dragino/TrackerD/Example/BLE_Indoor_Positioning_Software/BLE_Positioning/office_map.png

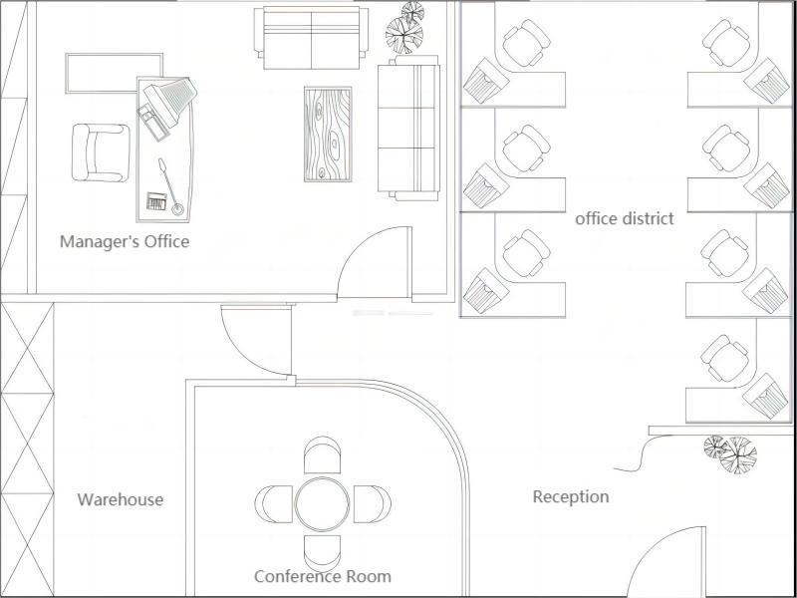
Example/BLE_Indoor_Positioning_Software/BLE_Positioning/office_map.png
