dragino/TrackerD/(threads)

Thread 11 (2022-12-11):

Enable/Disable LED (LON) is always set to ON state

Martin-100, 2022-12-11:
Common.cpp -> void SYS::config_Read(void) ->contains on line 618-622:

//lon
  lon = DATA.readUChar(addr1);           
  addr1 += sizeof(unsigned char);
  if(lon == 0)
    lon = 1;

So writing a 0 to disable the leds results in turning them back on again?

mkwillis, 2023-03-09:
Can this issue be fixed by editing the code?.... Its a highly annoying LED

namejinnameyuan, 2023-04-23:
Yes, you can compile the code to change it. I changed it in v1.4.4. Before, 1 was on and 2 was off.

P-etr, 2023-04-23:
Hi, my tracker has FW 1.4.4. and AT+LON keeps returning to 1.
So I can't turn off the LED. Is it possible to somehow turn off the LED now? Will this be fixed in future versions?

mkwillis, 2023-04-23:
Yes LED settings DO NOT stick... We need a fix pls

namejinnameyuan, 2023-04-24:
Hi
I will release a new version in the next few days, fix problems, and add features will be described

------------------&nbsp;原始邮件&nbsp;------------------
发件人:                                                                                                                        "dragino/TrackerD"                                                                                    ***@***.***&gt;;
发送时间:&nbsp;2023年4月23日(星期天) 晚上8:04
***@***.***&gt;;
***@***.******@***.***&gt;;
主题:&nbsp;Re: [dragino/TrackerD] Enable/Disable LED (LON) is always set to ON state (Issue #11)

Hi, my tracker has FW 1.4.4. and AT+LON keeps returning to 1.
 So I can't turn off the LED. Is it possible to somehow turn off the LED now? Will this be fixed in future versions?

—
Reply to this email directly, view it on GitHub, or unsubscribe.
You are receiving this because you commented.Message ID: ***@***.***&gt;

namejinnameyuan, 2023-04-24:
Hi
I will release a new version in the next few days, fix problems, and add features will be described

------------------&nbsp;原始邮件&nbsp;------------------
发件人:                                                                                                                        "dragino/TrackerD"                                                                                    ***@***.***&gt;;
发送时间:&nbsp;2023年4月23日(星期天) 晚上9:18
***@***.***&gt;;
***@***.******@***.***&gt;;
主题:&nbsp;Re: [dragino/TrackerD] Enable/Disable LED (LON) is always set to ON state (Issue #11)

Yes LED settings DO NOT stick... We need a fix pls

—
Reply to this email directly, view it on GitHub, or unsubscribe.
You are receiving this because you commented.Message ID: ***@***.***&gt;

Thread 12 (2023-01-22):

AT+FTIME value is multiplied by 1000 in the actual config

bienvuinfo, 2023-01-22:
TrackerD v1.4.4

Entering the command AT+FTIME=150
then checking the actual config with AT+CFG returns
AT+FTIME=150000

namejinnameyuan, 2023-04-23:
Set the time in seconds, and the milliseconds he uses in ESP32 will be converted

bienvuinfo, 2023-04-24:
I want to use AT+CFG to backup the actual device configuration then simply 'replay' the output to restore the config.

AT+FTIME is the only parameter that cannot restored 'as-is' and requires transformation.

It would be very convenient to have the same values.

namejinnameyuan, 2023-04-24:
ok, you want AT+FTIME also use MS as the unit?

------------------&nbsp;原始邮件&nbsp;------------------
发件人:                                                                                                                        "dragino/TrackerD"                                                                                    ***@***.***&gt;;
发送时间:&nbsp;2023年4月24日(星期一) 下午4:28
***@***.***&gt;;
***@***.******@***.***&gt;;
主题:&nbsp;Re: [dragino/TrackerD] AT+FTIME value is multiplied by 1000 in the actual config (Issue #12)

I want to use AT+CFG to backup the actual device configuration then simply 'replay' the output to restore the config.

AT+FTIME is the only parameter that cannot restored 'as-is' and requires transformation.

It would be very convenient to have the same values.

—
Reply to this email directly, view it on GitHub, or unsubscribe.
You are receiving this because you commented.Message ID: ***@***.***&gt;

bienvuinfo, 2023-05-01:
Yes, milliseconds.
Same unit in AT+CFG and AT+FTIME.
Thanks.

Thread 13 (2023-01-22):

Cannot modify the configuration with downlink messages

bienvuinfo, 2023-01-22:
TrackerD 1.4.4, TTN network V3

Clearing ALARM with the downlink payload 0x02 01 works well  as expected.

Unfortunately no other configuration parameter is actually changed with a downlink payload
f.ex:
```
0x01 00 01 2C // Same as AT+TDC=300000
0x03 00 01 2C // Same as AT+MTDC=3000000
0xAE 00 // Same as AT+LON=0
0xA5 01 00 00 // Same as AT+SMOD=1,0,0
```

The download messages are well received and decoded by the node.
```
BAT:4.00 V
1543393: UpLinkCounter = 1
EV_TXSTART
1555939: TXMODE, freq=868300000, len=18, SF=7, BW=125, CR=4/5, IH=0
Packet queued
start single rx: now-rxtime: 3
1871548: RXMODE_SINGLE, freq=868300000, SF=7, BW=125, CR=4/5, IH=0
Rssi=-63
1874664: EV_TXCOMPLETE (includes waiting for RX windows)
**Received:A5 02 00 02**
Received ack
Enter sleep mode
```

My Configuration
```
AT+MODEL=TrackerD ,v1.4.4
AT+ADR=1
AT+DR=5
AT+TXP=0
AT+SMOD=1,0,1
AT+TDC=120000
AT+MTDC=100000
AT+ATDC=30000
AT+FTIME=90000
AT+INTWK=1
AT+LON=1
AT+CHE=1
AT+NMEA353=0
AT+NMEA886=0
AT+CFM=1
AT+PNACKMD=1
AT+PDOP=7.00
AT+DWELLT=0
AT+SHOWID=0
AT+BLEMASK==0
AT+WiFiMASK==0
AT+PT=14
```

namejinnameyuan, 2023-04-23:
I checked what is the problem and I will fix it in the latest version V.1.4.5

alternator7, 2024-07-29:
@namejinnameyuan Was this resolved?  We are experiencing the same problem with downlink payloads not changing parameters on the device.  We don't any commits based on this issue...

namejinnameyuan, 2024-07-30:
Downlink modification SMOD, fixed

Thread 15 (2023-02-17):

Realtime GNSS Positioning with Altitude and hdop

kbox-one, 2023-02-17:
Would be great to have a more detailed GNSS positioning information with altidude and hdop. Maybe you could add one using Uplink on FPORT=9 ?

ffries, 2023-04-10:
+1
I really need this feature.

namejinnameyuan, 2023-04-23:
Need to add height and HDOP? Playload will be exceeded on some frequency bands, and some SFs are not applicable.
Does the alarm only need to be reported once and then automatically exit?

kbox-one, 2023-04-24:
I have no special demands for the alarm function. But I would be very happy if there is an additonal FPORT number (for example 9) that contains at least the following payload:
Latitude + Longitude + Altitude + HDOP(or PDOP)
Size (bytes) would be only = 4 + 4 + 2 + 1
That would not exceed the maximum size as it is smaller than the FPORT=2 payload :-)

namejinnameyuan, 2023-04-25:
I am busy with other things, I will add it when I am free
------------------&nbsp;原始邮件&nbsp;------------------
发件人:                                                                                                                        "dragino/TrackerD"                                                                                    ***@***.***&gt;;
发送时间:&nbsp;2023年4月25日(星期二) 凌晨0:07
***@***.***&gt;;
***@***.******@***.***&gt;;
主题:&nbsp;Re: [dragino/TrackerD] Realtime GNSS Positioning with Altitude and hdop (Issue #15)

I have no special demands for the alarm function. But I would be very happy if there is an additonal FPORT number (for example 9) that contains at least the following payload:
 Latitude + Longitude + Altitude + HDOP(or PDOP)
 Size (bytes) would be only = 4 + 4 + 2 + 1
 That would not exceed the maximum size as it is smaller than the FPORT=2 payload :-)

—
Reply to this email directly, view it on GitHub, or unsubscribe.
You are receiving this because you commented.Message ID: ***@***.***&gt;

Thread 16 (2023-04-10):

Trackerd does not go in sleep mode when in transport mode with no GPS available

ffries, 2023-04-10:
Dear all,

First let me explain what I need trackerd for : I want to do real-time mapping when I drive my car. (only a few days in a year when mapping my own networks to respect fair-use policies).  I would like to start mapping automatically when driving and I would like trackerd to go on sleep automatically when not moving.

Trackerd is connected to USB port in my car and is sitting right in front of the car glass with good visibility on the sky. The problem is that when GPS is lost inside the garage, trackerd does not go on sleep and led is flashing all the time looking for a GPS. Then battery goes off and I need to restart the car to power trackerd.

Trackerd is by now sitting on the floor with no movement and no vibration. It is sill blinking constanly until it goes off, so it could be looking for GPS before sleeping. If I connect to USB, as motion detection is on, it goes instantly on looking for GPS so I don't know precisely what is going on.

Is this a bug or a feature, please help. Here is my configuration:

```
AT+MODEL=TrackerD ,v1.4.4                        
AT+ADR=0                                                                
AT+DR=5                                                                 
AT+TXP=0                                                                
AT+SMOD=1,0,0                                                           
AT+TDC=1800000                                                          
AT+MTDC=300000                                                          
AT+ATDC=60000                                                           
AT+FTIME=150000                                                         
AT+INTWK=1                                                              
AT+LON=1                                                                
AT+CHE=0                                                                
AT+NMEA353=0                                                            
AT+NMEA886=1                                                            
AT+CFM=0                                                                
AT+PNACKMD=0                                                            
AT+PDOP=7.00                                                            
AT+DWELLT=0                                                             
AT+SHOWID=0                                                             
AT+BLEMASK=                                                             
AT+WiFiMASK=                                                            
AT+PT=14
```

ffries, 2023-04-10:
Sorry for the confusion, trackerd was in alarm mode.
It was pressed by my cat by error!

ffries, 2023-04-10:
Closing issue.

ffries, 2023-04-10:
Reopening, trackerd is still blinking.

ffries, 2023-04-11:
I found that AT+FTIME=150000000
I don't remember setting such a high value.

ffries, 2023-04-11:
My fault, I did set AT+FTIME=180000 by error copying the result from configuration

namejinnameyuan, 2023-04-23:
The setting unit of AT+FTIME command is S, three minutes AT+FTIME=180s.
The positioning is not successful, which may be the reason for the weak GPS signal.

executed, 2025-07-05:
I guess this issue can be closed now

Thread 19 (2023-05-18):

EEPROM class size argument

c08oliverbrian, 2023-05-18:
TrackerD file does not pass a size for EEPROM in common.cpp, cannot call this function without. The matchin class call should be

    EEPROMClass(const char* name, uint32_t user_defined_size);

so these throw error
EEPROMClass  KEY("eeprom0");
EEPROMClass  DATA("eeprom1");
EEPROMClass  GPSDATA("eeprom2");

c08oliverbrian, 2023-05-18:
chaaging to this allowed compilation in Arduino IDE
EEPROMClass  KEY("eeprom0", EEPROM_KEY_SIZE);
EEPROMClass  DATA("eeprom1", EEPROM_DATA_SIZE);
EEPROMClass  GPSDATA("eeprom2", EEPROM_GPSDATA_SIZE);

Closed 2023-05-18.

Thread 20 (2023-05-18):

gpio_sleep_set_direction

c08oliverbrian, 2023-05-18:
ESP32 V1.0.4 gpio.h does not define  gpio_sleep_set_direction() used in common.cpp

namejinnameyuan, 2023-05-26:
Yes, there is no statement, it can be used, I will upload the latest firmware, I changed the way to turn off GPIO, and successfully reduced the sleep current.

Thread 22 (2023-10-21):

FAILURE  .pio/libdeps/dragino_lbt2/MCCI LoRaWAN LMIC library/src/lmic/oslmic.c:53

yhurynovich, 2023-10-21:
Dragino TrackerD
FAILURE
.pio/libdeps/dragino_lbt2/MCCI LoRaWAN LMIC library/src/lmic/oslmic.c:53

yhurynovich, 2024-01-24:
Yes. All good now.

Thank you!

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

--
Best regards,

Yury Hurynovich

CaianBrum, 2024-01-24:
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

can you share with me? please?

executed, 2025-07-05:
I overcame this issue without installing Arduino.
If you take a look at Example/LoRaWAN/examples/extras contents you'll see the scripts already correcting those SPI pins.
Those scripts are defined to be executed in platformio.ini file.

My problem was that **pio run** script failed to apply those because **patch** command was not included into PATH in my Windows OS env variables.
What I did next:
- went to .platformio\packages\framework-arduinoespressif32
- deleted .patching-done file
- restarted firmware build using **pio run**
- flashed firmware using Espressiff ESP32 Flash Tool

Thread 23 (2024-04-23):

Release 1.4.9 Missing

athanas, 2024-04-23:
There seems to be an issue with the released code.  Even though 1.4.9 is the stated latest release, the latest code posted is 1.4.6 according to common.h.  In the listed releases, versions 1.4.9 and 1.4.7 are identical and both actually are release 1.4.6.  The features described in the 1.4.9 release notes are not present in the code.  Was there a missing “push” before the release?

You’ve done a really nice job with this project.

namejinnameyuan, 2024-06-18:
The latest version of the program has now been uploaded

Thread 26 (2024-08-06):

TrackerD -LS (Solar)  BLE Bluetooth Remote Configure

kaciker, 2024-08-06:
Hello
I bought one unit of this sensor to test, but even in the doc Dragino i readed that all models  with -LB, -LS , -NB, -NS suffix are able to be set remotelly by bluetooth, I can not see any information about that in the offical docs,
Maybe even is a LS model, this model is not included  ?

kaciker, 2024-08-07:
> This is a solar powered version, which is different from our other products. It does not support Bluetooth remote modification.

Ok, I understood, but then is a little confusing to name this sensor with the suffix -LS  and after indicates in the doc for remotelly set by bluetooth "..models with -LB, -LS , -NB, -NS suffix are able to be set remotelly by bluetooth" maybe a exception in the info is needed. Is only a suggestion

Thread 27 (2024-08-06):

Tracker D - SMOD=3,0,1 (GPS + BLT)

kaciker, 2024-08-06:
My Conf:
AT+MODEL=TrackerD ,v1.4.8

AT+ADR=1
AT+DR=5
AT+TXP=0
AT+NJM=1
AT+SMOD=3,0,1
AT+TDC=100000
AT+MTDC=300000
AT+ATDC=60000
AT+FTIME=180
AT+INTWK=0
AT+LON=1
AT+CHS=0
AT+CHE=1
AT+NMEA353=0
AT+NMEA886=0
AT+CFM=0
AT+PNACKMD=0
AT+PDOP=7.00
AT+DWELLT=0
AT+SHOWID=0
AT+BLEMASK=
AT+WiFiMASK=
AT+PT=14
AT+ATST=15
AT+PM=0
AT+FD=0
AT+BG=0
AT+BEEP=0
AT+EAT=2
AT+GF=1

The info in the Dragino doc.

3.2.7  Set Positioning Mode
SMOD define how TrackerD scan and uplink data:

AT Command:
AT+SMOD=aa,bb,cc

 aa:

1: GPS ONLY(Factory Settings):    Only get and uplink GPS location info.
2: BLE or WiFi ONLY:                     Only obtain iBeacon info via BLE and uplink  or obtain WiFi ssid info via WiFi and uplink. Design for Indoor tracking.
3: GPS/BLE Hybrid:                       Combination for Indoor and Outdoor tracking.Devices will try to search BLE iBeacon first. If device can't find the iBeacon, it will use GPS for positioning.
bb:

0 :  GPS+ BAT+ State+Tem&Hum
1 :  GPS +BAT State
cc:

1 :  (iBeacon)UUID+ Major + Minor+Power+Rssi+BAT+State

2 :  (WiFi)SSID+Rssi+BAT+State (V1.4.1 Version support this function later)
Example:

  AT+SMOD=1,0,0    -->    GPS+ BAT+ State+Tem&Hum

  AT+SMOD=1,1,0    -->    GPS +BAT State

  AT+SMOD=2,0,1    -->    (iBeacon)UUID+ Major + Minor+Power+Rssi+BAT+State

  AT+SMOD=2,0,2    -->    (WiFi)SSID+Rssi+BAT+State

  AT+SMOD=2,0,3    -->    (iBeacon) (Major + Minor+Rssi)+(Major + Minor+Rssi)+...(Maximum forty group)...+BAT+State

Downlink Payload (prefix 0xA5):
0xA5 01 00 00       //  Same as AT+SMOD=1,0,0

My problem and question:

Question. It is possible that there are some mistake in the doc ? the last example AT+SMOD=2,0,3 is not possilbe if we read the previous info due to in the AT+SMOD=aa,bb,cc  the cc has only two options iBeacon/wiifi, then , what about that last "3"  in the SMOD=2,0,3 ??

My problem.
I test all options with the aa in the SMOD=3,x,x and I never have ibeacon+gps I only can have ibeacon or gps, setting aa=1 or 2  but never both with option 3

namejinnameyuan, 2024-08-07:
AT+SMOD=2,0,3, this is to obtain a lot of beacons, up to 40 are supported.
SMOD=3,x,x This is the hybrid mode. If no beacon is scanned, switch to GPS. This is to choose one of the two.

kaciker, 2024-08-07:
> AT+SMOD=2,0,3, this is to obtain a lot of beacons, up to 40 are supported. SMOD=3,x,x This is the hybrid mode. If no beacon is scanned, switch to GPS. This is to choose one of the two.

You are totally right. The doc is clear.. my mistake, I was always setting the sensor with the BCN02 so close to it.. thanks, I have moved the devices away and started to report Fport2 with gps.
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

It is not possible to set the device to have temp/hum data, when  iBeacon is reporting ? doc inform that is only available in gps mode bb=0

namejinnameyuan, 2024-08-08:
When uploading beacon data, temperature and humidity data are not added.
GPS adds temperature and humidity data, bb=0;

Thread 28 (2024-08-07):

BLMASK  filtering

kaciker, 2024-08-07:
Hello,

I'm having problems using the BLMASK filtering.

I need to filter the UUIDs of the BCN05 beacons that we installed so that we do not receive UUIDs from other  (BLE) devices in the area from other projects.

If I deactivate the BLMASK by setting it to 0, the tracker gives me the strongest UUID, but sometimes it provides UUIDs from other devices that are not BCN05, which disrupts the project.

To address this, I tried to set the BLMASK. According to the Dragino documentation, the BLMASK needs to be between 6 and 10 bytes. The standard UUID for the Dragino BCN05 is 0112233445566778899aabbccddeeff0, which is 16 bytes. However, the sensor does not allow me to set BLMASK to 0112233445566778899aabbccddeeff0 and only allows me to set 6 bytes. With this 6-byte setting,AT+BLEMASK=0112233445 filtering does not work, and as a result, the GPS is activated all the time, and the BLE iBeacon functionality ceases to work.

What am I doing wrong?

namejinnameyuan, 2024-08-08:
The BLMASK setting filters out the beacons you don’t need, such as UUID: 0112233445566778899aabbccddeeff0. If you don’t need this type of beacon, then set BLMASK to 011225, and the beacon will not be scanned. If the RSSI of the beacon exceeds -90, it will also be filtered out.
sc_count = 0 This means there is no useful beacon scanned

kaciker, 2024-08-08:
> The BLMASK setting filters out the beacons you don’t need, such as UUID: 0112233445566778899aabbccddeeff0. If you don’t need this type of beacon, then set BLMASK to 011225, and the beacon will not be scanned. If the RSSI of the beacon exceeds -90, it will also be filtered out. sc_count = 0 This means there is no useful beacon scanned

Hello
 I don't know where is the mistake, in your answer or in the dragino doc.

"...3.2.12  Set BLEMASK to filter BLE iBeacon
BLEMASK is to filter the unwanted BLE iBeacons during scan. **For example, if BLEMASK is 123456. TrackerD will only uplink UUID info which includes 123456**. **It will ignore all other iBeacons** which doesn’t contact 123456 in the UUID.

Note: BLEMASK range is 6 ~ 10 bytes. If AT+BLEMASK < 6 bytes, BLEMASK will be disabled.

namejinnameyuan, 2024-08-08:
Yes, filter out beacons other than BLEMASK, and set the length to 6~10.

namejinnameyuan, 2024-08-08:
You can use AT+SHOWID=1 to see the scanning information. If the signal strength of the beacon is lower than -90, it will be abandoned.

Thread 29 (2024-08-11):

Communicating with the L70 GPS module

athanas, 2024-08-11:
The code uses the SerialGPS device in GPS.cpp to retrieve NMEA data from the L70 module.  I have an application where I'd like to use the AllwaysLocate capabilities of the L70 (see Section 3.4.5 of https://docs.rs-online.com/74ea/0900766b8147dbe2.pdf).  To do so, I need to send the NMEA command $PMTK255,8*23 to the L70.  The problem is that no matter what command that I send to the L70, it seems to be ignored.  For example,
```
if SerialGPS.availableForWrite() >20) {
   // The code reaches this point with plenty of write buffer space
   SerialGPS.write("$PMTK255,8*23\r\n");
}
```
This should provide a NMEA response of $PMTK001,225,3*33.  In fact, I see no effect or response from any command that I issue.

The PCB layout shows the RX/TX lines properly connected between the L70 and the ESP32.  Any idea why this is not working?

namejinnameyuan, 2024-08-14:
Our TrackerD currently uses the GPS model L76K, which does not have this command

Thread 30 (2024-08-20):

TX Power missing in documentation BCN05

kaciker, 2024-08-20:
Hello

We're trying to deploy a trilateration project, with TrackerD, and ussing for iBeacon BCN05.
We need the standrad value for TXPower in BCN05 to be precise.
Can you provide me please

namejinnameyuan, 2024-08-21:
The beacon we sell is BCN02, and the distance should be calculated by RSSI.

namejinnameyuan, 2024-08-21:
The standard value should be the cal RSSI parameter

kaciker, 2024-08-21:
Hello,
You're right is BCN02, my mistake. We bought more than 100 to this project.

Txpower transmission power is the standard value that the ibeacon device transmit.
The RSSI is the power that the sensor see from this sent by the ibeacon.

Is true that if all ibeacon are the same (BCN02) this txpower will be the same, other brands inform about 56 or 59 value, and we are using this value with Dragino too.

For teilateration script the TxPower is necessary with RSSI to calculate real position. And could be good to know the spec in BNC 02

namejinnameyuan, 2024-08-22:
The range of txpower is -19.5~+2.5. There is an APP display picture on our wiki with a txpower parameter. Add the value you need to change, and then APPLY.
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

kaciker, 2024-08-22:
> The range of txpower is -19.5~+2.5. There is an APP display picture on our wiki with a txpower parameter. Add the value you need to change, and then APPLY. ![image](https://private-user-images.githubusercontent.com/35789561/360231743-e154616a-2b82-4b2c-92da-39b2d1b5a1ca.png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)

Thanks this is that we needed. Do you think that could be posible to Dragino D, to read this value by Blt ? I saw in the payload that is not, and th specs does not talk about that TXPower to be transmited

namejinnameyuan, 2024-08-22:
The payload of the ibeacon does not have this parameter, so TrackerD cannot obtain this data. To calculate the distance, RSSI and RSSI@1 meter calibration power should be used.
These two parameters, TrackerD contains

kaciker, 2024-08-22:
> The payload of the ibeacon does not have this parameter, so TrackerD cannot obtain this data. To calculate the distance, RSSI and RSSI@1 meter calibration power should be used. These two parameters, TrackerD contains

What is RSSI@1 ??

namejinnameyuan, 2024-08-23:
RSSI@1 is the absolute value of the RSSI received when the mobile phone is 1m away from the Bluetooth beacon.
txPower parameter (reports the RSSI power at a distance of 1 meter).

namejinnameyuan, 2024-08-26:
The value set by the beacon is C5 or C3, which you can see in the payload.

kaciker, 2024-08-26:
> The value set by the beacon is C5 or C3, which you can see in the payload.

In the decode for Chirpstack --> dragino/dragino-end-node-decoder/tree/main/TrackerD)
/TrackerD Chirpstack V4 Decoder 1.4.5 .txt    There are not any information about those values. C5, and C3, the payload only report 		return {
		  BatV:batV,
		  ALARM_status:alarm,
		  MD:mod,
		  LON:led_updown,
		  UUID: uuid,
		  MAJOR: major,
		  MINOR: minor,
		  RSSI:rssi,
		  POWER:power,
		  };

namejinnameyuan, 2024-08-28:
BLE decoding uses the following method:

	if(port==0x06)
	{
		major =  bytes[16] << 8 | bytes[17];

		minor =  bytes[18] << 8 | bytes[19];

		power = bytes[15];

		rssi1m = bytes[21]<<24>>24;

		rssi =  bytes[23]<<24>>24;

		con = "";
		for(i = 0 ; i < 16 ; i++) {
			con += bytes[i].toString(16);
		}
		value =  con;
		var uuid = value;
		alarm=(bytes[24] & 0x40)?"TRUE":"FALSE";//Alarm status
		batV=(((bytes[24] & 0x3f) <<8) | bytes[25])/1000;//Battery,units:V
		mod = (bytes[26] & 0xC0)>>6;
		led_updown=(bytes[26] & 0x20)?"ON":"OFF";//LED status for position,uplink and downlink
		if(bytes[26] & 0xC0==0x40)
		{
			hum=(bytes[27]<<8 | bytes[28])/10;//hum,units: °
			tem=(bytes[29]<<8 | bytes[30])/10; //tem,units: °
		}
		return {
		  BatV:batV,
		  ALARM_status:alarm,
		  MD:mod,
		  LON:led_updown,
		  UUID: uuid,
		  MAJOR: major,
		  MINOR: minor,
		  RSSI:rssi,
		  RSSI1M:rssi1m,
		  POWER:power,
		  };
	}

Thread 31 (2024-08-29):

Unit is not starting after longer storage in the dark

HB9IIU, 2024-08-29:
We never managed to get this thing working correctly, and here are my latest observations:
If the unit was stored for a longer period in the dark, causing the battery to discharge, it will not start automatically when the battery is charged again under sunlight. I was forced to reopen it and unplug/replug the battery to get it working, as pressing the button had no effect.
We are using firmware version 1.5.1, but we will not implement this on a larger scale (such as a truck fleet) due to its unreliability.

namejinnameyuan, 2024-09-07:
Hello, is the battery charged to more than 2.8V? Otherwise, it will not start because the ESP32 will have a very high current when it starts. We will reproduce the problem you described. Can you tell me the version number on the PCB board?

niklaswelin, 2024-09-15:
TrackerD-LS same problem didnt turn on "new from package".. only way i managed to get it up and running was to connect the usb cable to my desktop. and now i dont know if i can diconnect the cable or not will the tracker shot down or what ?

namejinnameyuan, 2024-09-19:
You need to create a node on TTN and then activate TrackerD-LS. You can see the TrackerD-LS activity information on TTN. You can also use USB to connect to the PC and use the serial port tool to view the information. When the battery power is sufficient, disconnect the USB cable, it will remain active, and data messages will be sent uplink according to the TDC time interval.

Thread 32 (2024-11-04):

Version Mismatch, Static Battery Voltage, and TTN Payload Formatter Malfunction

Uhlfred, 2024-11-04:
Hardware: TrackerD-LS HW v1.3

I’ve encountered multiple issues with the TrackerD-LS hardware on firmware version v1.5.1.

Details:

**1. Version Number Discrepancy:**

- After updating a new device to firmware v1.5.1, the update completes successfully. However, when querying the device, the version is reported as:
`AT+MODEL=TrackerD-LS ,v1.0.3`
- When rolling back to a previous version, such as v1.4.3, the version displays correctly. Given that AT+BTDC is available, I assume the update process was technically successful, but the version reporting seems incorrect?
- I cleared the flash, attempted the EEPROM reset process, and performed AT+FDR. No change.

**2. Static Battery Voltage:**

- The device consistently reports a battery voltage of 4.002 V, regardless of actual battery level. This static reading appears erroneous and does not reflect actual battery status.

**3. TTN Payload Formatter Issue:**

- I copied the v1.5.1 payload formatter into TTN. While location data is transmitted, TTN does not seem to recognize or process it correctly, which in turn prevents the location data from being forwarded to Mapper.

Any insights into resolving these issues would be appreciated.

`AT+MODEL=TrackerD-LS ,v1.0.3
.
.
.
AT+ADR=1
AT+DR=5
AT+TXP=0
AT+NJM=1
AT+SMOD=1,0,0
AT+TDC=300000
AT+MTDC=60000
AT+ATDC=60000
AT+FTIME=180
AT+INTWK=1
AT+LON=1
AT+CHE=1
AT+CHS=0
AT+NMEA353=0
AT+NMEA886=0
AT+CFM=0
AT+PNACKMD=0
AT+PDOP=7.00
AT+DWELLT=0
AT+SHOWID=0
AT+BLEMASK=
AT+WiFiMASK=
AT+PT=19
AT+ATST=15
AT+PM=0
AT+FD=0
AT+BG=0
AT+BEEP=0
AT+EAT=2000
AT+GF=1
AT+DEVICE=22
AT+BTDC=0`

Uhlfred, 2024-11-06:
**3. TTN Payload Formatter Issue:**

Let me start by replying to myself:

Regarding the payload, I at least got the location to work.
WARNING: I am not a professional, and everything I do might be completely wrong.

**Problem:**
The TTN application was not recognizing the GPS coordinates (latitude and longitude) from the payload. This was likely because TTN expects latitude and longitude to be at the root level of the JSON payload, with specific field names in lowercase.

**Solution:**
To address this, I modified the decoder function to return latitude and longitude as root-level fields in the JSON output for Ports 2 and 3, ensuring they are correctly named in lowercase. This allows TTN to detect and display the GPS coordinates as intended.

**However, it seems there are more issues here. The timestamp isn’t being decoded or displayed.**

		if (port == 2) {
			return {
				latitude: latitude,
				longitude: longitude,
				location_tago: location_tago,
				Hum: hum,
				Tem: tem,
				BatV: batV,
				ALARM_status: alarm,
				MD: mod,
				Bg: BG,
				Date: date,
				Time: time,
				LON: led_updown,
				Transport: intwk,
			};
		} else if (port == 3) {
			return {
				latitude: latitude,
				longitude: longitude,
				location_tago: location_tago,
				BatV: batV,
				ALARM_status: alarm,
				MD: mod,
				LON: led_updown,
				Transport: intwk,
			};
		}
	}

umsenn, 2024-12-09:
**2. Static Battery Voltage:**
The measurement of the battery voltage is done by reading out the GPIO34 Pin of the ESP32 using the analogRead() function. The result of this function is an integer value in the range 0 .. 4095 which represents a voltage in the range 0.0 .. 3.3 Volts at the GPIO34 Pin. Since the battery voltage of the Li-on Battery may range up to 4.2 Volts and the maximum voltage at the input pins of the ESP32 should not exceed 3.7 Volts, a voltage divider (two resistors) was placed between the battery voltage pin and GPIO34. The design of this voltage divider is however not quite perfect, so the circuit can not measure battery voltages above around 4.0 Volts.
So whenever the TrackerD-LS device reports a battery voltage of 4.002 Volts it means that the actual battery voltage is somewhere above 4.0 Volts (e.g. 4.2 Volts). Reported values below 4.002 Volts should however represent the actual battery voltage.

namejinnameyuan, 2024-12-18:
The maximum voltage collected by ESP32 is 3.3V, and the maximum voltage of lithium battery is 4.2V, so voltage division is needed to collect voltage, which will cause it to be at 4.002V for a long time. Only when the battery voltage is lower than 4.002V can the battery change be seen.

There is a link to the TTN decoder in our wiki, this one has been tested

You need to set AT+BTDC. Please upgrade to version 1.5.2 or 1.5.3. 1.5.1 may have errors.

Thread 33 (2024-12-06):

TrackerD.ino in v1.5.2 Release does not compile

umsenn, 2024-12-06:
The module `TrackerD.ino` does not compile due to a wrong variable name in line 716:
```
     // If the device is in TTN Mapper mode, we disable the log gps feature
     // as it could result in invalid date being sent to TTN Mapper
      if (sys.mod == 2)
      {
	sys.loggpsdata = 0;
      }

```
code line 716 should most likely be:
`	     sys.loggpsdata_send = 0;
`

namejinnameyuan, 2024-12-18:
yes，sys.loggpsdata_send

Thread 34 (2024-12-09):

“TrackerD v1.3.layout.pdf” and “TrackerD v1.3.silkscreen.pdf”  missing

umsenn, 2024-12-09:
The hardware documents in [https://github.com/dragino/TrackerD/tree/main/hardware](https://github.com/dragino/TrackerD/tree/main/hardware) do not represent the actual v1.3 hardware release.

The v1.3 schematic diagram is also missing there but can be found using the corresponding shared folder link on the dragino website https://www.dragino.com/products/tracker/item/234-trackerd.html .

namejinnameyuan, 2024-12-18:
Yes, the new design has not been updated to the above, only the interrupt IO has been changed. The new version of the hardware has an interrupt IO of pin 25.

Thread 39 (2025-02-16):

What is the license of the code

jcea, 2025-02-16:
I can't find what is the license of this code. I would consider to join the effort, since the hardware is quite nice and I already have a handful of units, but I need to know what is the license of the code. Currently, this is not open source in the legal sense, just publishing the code is not enough.

Checking some of the libraries, like "onebutton" or "tinygps++", I see a mix of licenses, but "OTAA_FULL_FUNCTION", has no license neither copyright attached, as far as I know.

namejinnameyuan, 2025-02-17:
We only maintain TrackerD, the other two are examples. These are open source, and the required files are in the documentation.

jcea, 2025-02-17:
What is the license of the code? Where is that documented?

Thanks.

namejinnameyuan, 2025-02-17:
What license? I don't understand. For example, "onebutton" or "tinygps++" can be installed by yourself on the arduino ide.

jcea, 2025-02-17:
License: Something like MIT, BSD; GPL2, GPL3...

A license defines the terms of usage, change, redistribution. Rights and obligations to whoever touch the source code.

Some details: https://en.wikipedia.org/wiki/Software_license

jcea, 2025-02-17:
For example, if the code can be changed freely with no obligation at all, an appropriate license would be MIT: https://en.wikipedia.org/wiki/MIT_License

I would be quite amused that Dragino do not care about this sourcecode...

In any case, to have contributions, a license must be defined first.

jcea, 2025-02-17:
For example, check some of the code you are using:

OneButton: BSD-like license. Details: http://www.mathertel.de/License.aspx

Tinygps++: LGPL 2.1 or later. Details: https://en.wikipedia.org/wiki/GNU_Lesser_General_Public_License

Thread 41 (2025-04-07):

Tracker D-LS no JoinAccept after platformIO upload

jseusx, 2025-04-07:
I recently updated the Tracker D-LS using the "flash download tool" using the pre-compiled firmware. It worked, however, I am currently modifying the code and adding a new function using VScode and PlatformIO (PIO).
Using PIO I was able to build the code but when I use "upload" with the device connected it causes my tracker to no longer join the network.
### Things I have checked
When I initially flashed it, initially keys (DEUI, APPKEY, DADDR, etc.), were wiped as I manually erased the partitions.
However, after changing them to their appropriate values it still does not connect.
- I flashed it again with the precompiled firmware using "flash download tool".
    - The device works that way without any changes to the keys.
- However, when I upload the firmare through vscode/PIO does it stop working and gives me the "No JoinAccept".
- I know some other devices require a specific command to join again after the keys has been wiped out (AT+UUID=666666666666), but this doesn't work with this device

I have attached a picture of the error I receive:
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

Let me know what could be the issue or how I could solve this. Thank you

jseusx, 2025-04-11:
I figured out it had to do with changing region in Platform.ini, config.h, and LMIC_project_config.h. I just commented out eu region and added the us region for it to work. It now works.

jseusx, 2025-04-16:
I ended up finding a simpler solution. Go to platform.ini and just uncomment in the one you want and comment out the one you don't want.

Closed 2025-04-11.

Thread 45 (2025-06-08):

Missing Files V1.5.6

sebasrpalacio95, 2025-06-08:
In the files for version 1.5.6, the partitions, app0, or bootloader files needed to flash the firmware on the TrackerD are missing.
Is it possible to use the app0, bootloader, and partitions from another version?
I appreciate a prompt response, thank you very much.

Mclupo, 2025-06-09:
the trackerd device needs all these files only for the first time. Later on only the eur868.bin or any other frequency file needs to be uploaded, beginning at address 0x10000

Mclupo, 2025-06-09:
Sorry , you are right, it's espressif flash tool. I also had a fresh device with 1.5.1 and it worked for me.

Thread 49 (2025-08-08):

No battery level and wrong follow up alarm status in v1.5.6

seanbaker74, 2025-08-08:
Received a Trackerd from a distributor pre-loaded with 1.5.6. The previous one I received was loaded with 1.5.2.

Issue 1: In FPort 2, BatV value is always 0

Issue 2: In FPort 2, when the alarm is active the ALARM_status value is FALSE

I resolved both issues by downgrading to version 1.5.2.

seanbaker74, 2025-08-10:
I am closing this because I realized the issue was related to the codec version I was using in Chirpstack. I upgraded to 1.5.6, then switched to the 1.5.4 codec and it is reporting those values properly now.

Closed 2025-08-10.
