dragino/TrackerD/hardware/TrackerD v1.2.sch.pdf

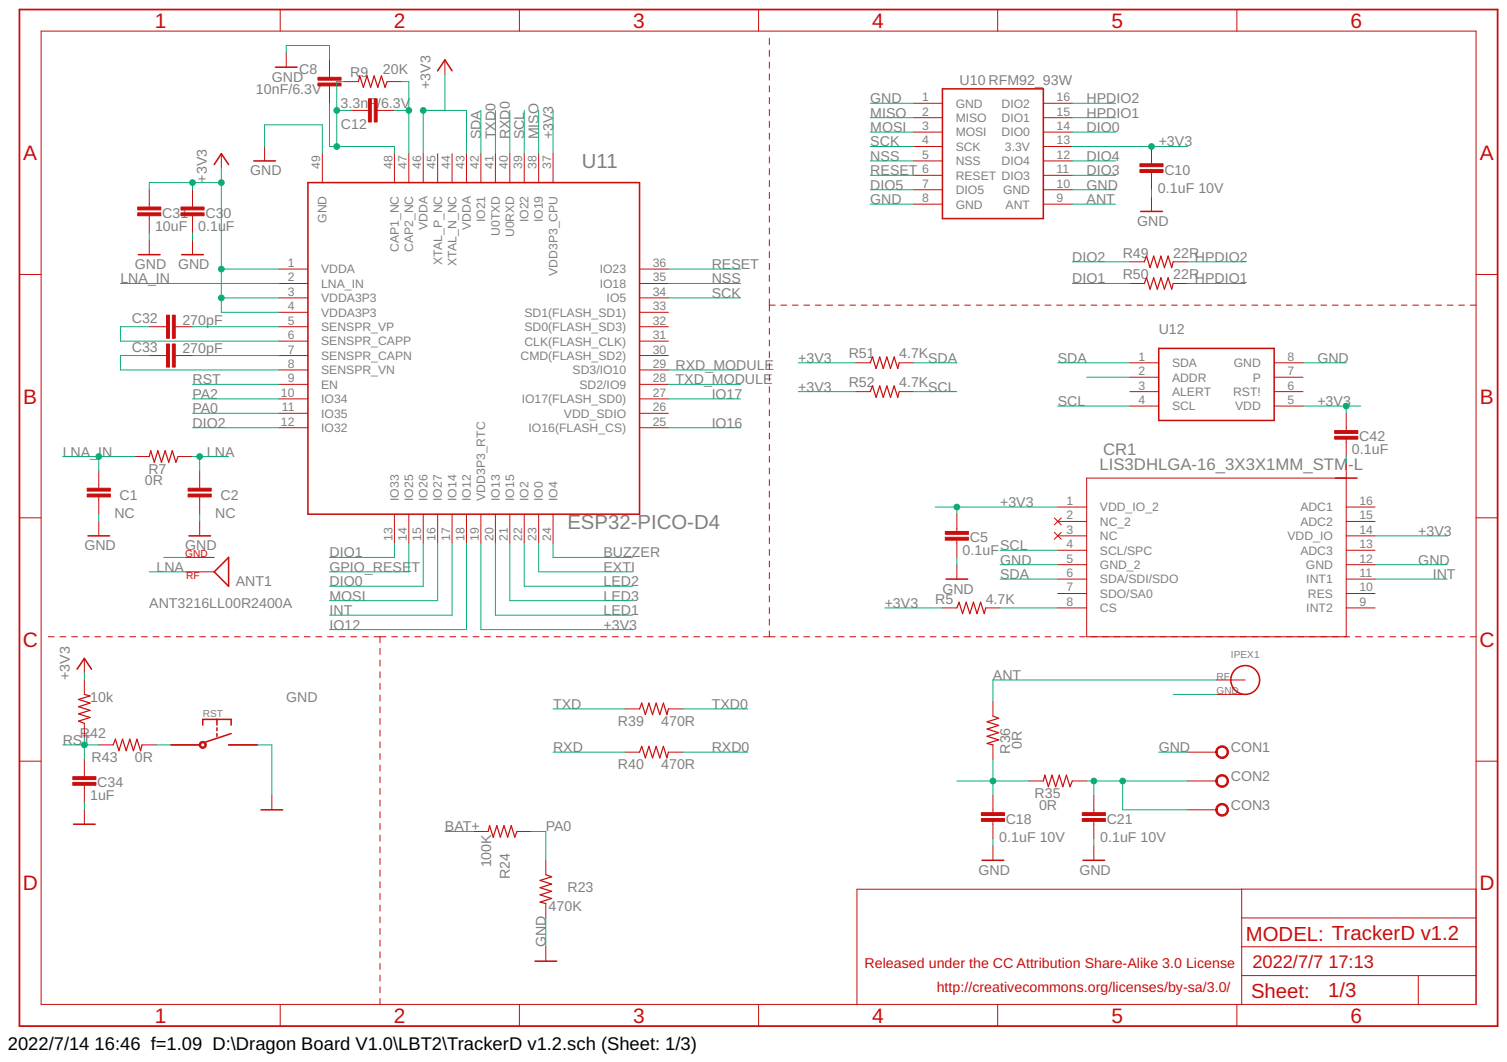
[picture p2: page 1]

Sheet: http://creativecommons.org/licenses/by-sa/3.0/

2022/7/14 16:46 f=1.09 D:\Dragon Board V1.0\LBT2\TrackerD v1.2.sch (Sheet: 1/3)

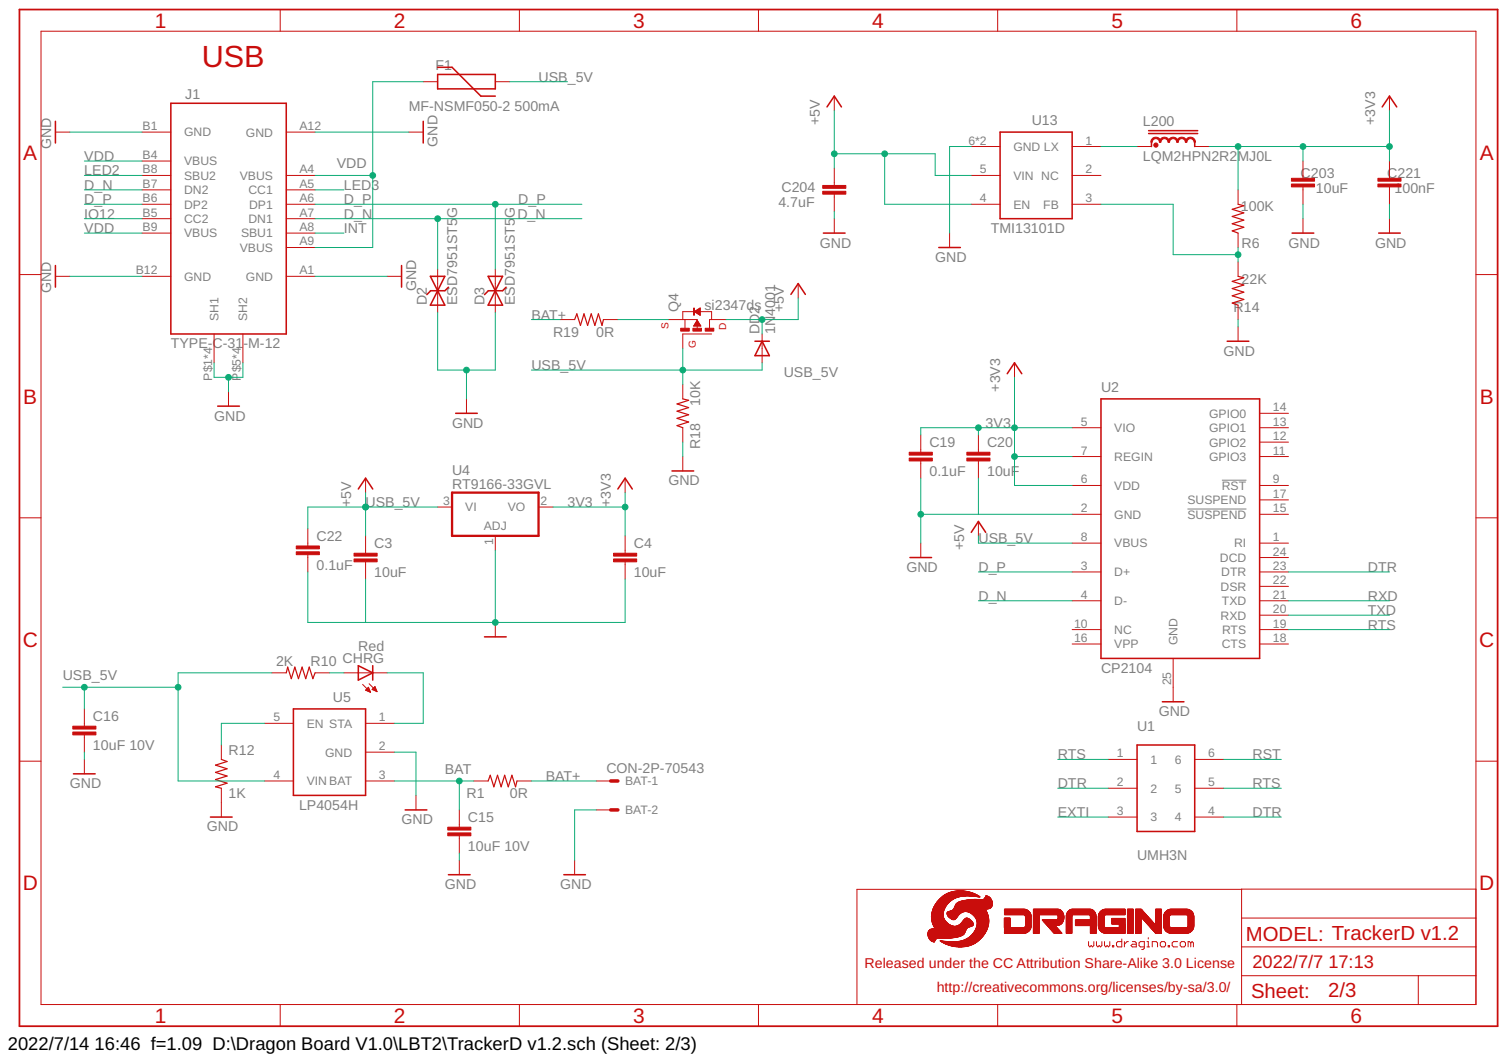
[picture p3: page 2]

Sheet: http://creativecommons.org/licenses/by-sa/3.0/

2022/7/14 16:46 f=1.09 D:\Dragon Board V1.0\LBT2\TrackerD v1.2.sch (Sheet: 2/3)

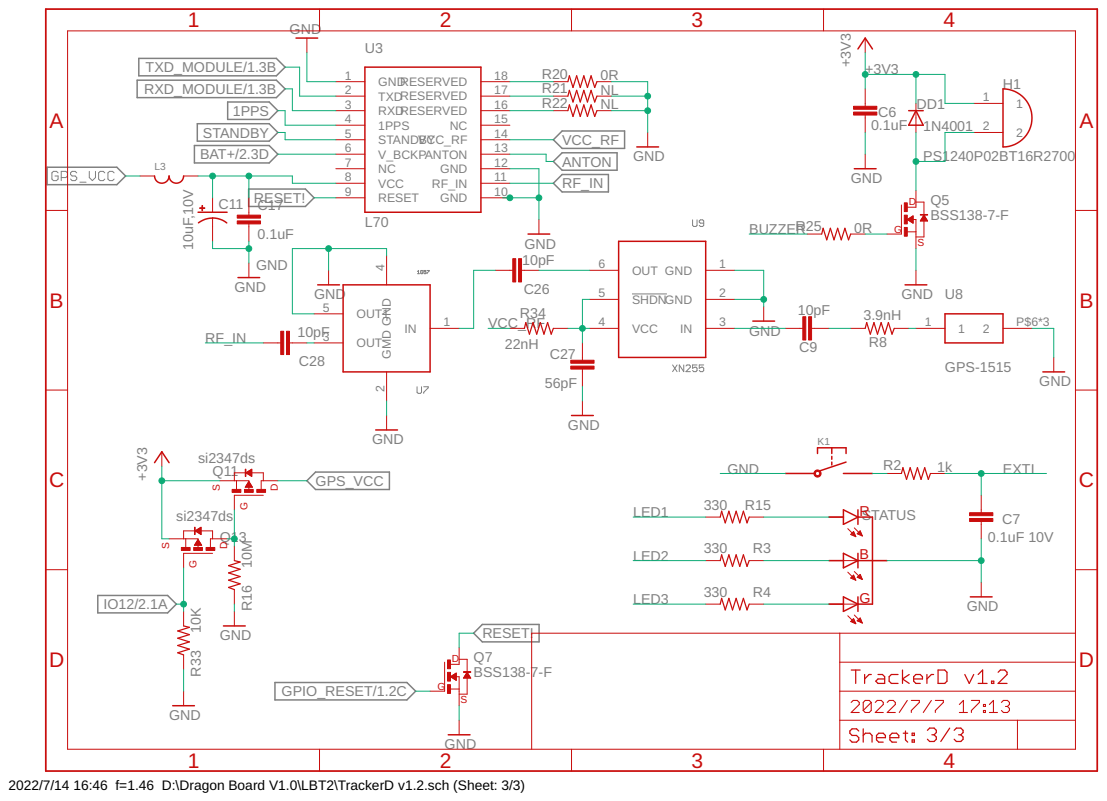
[picture p4: page 3]

2022/7/14 16:46 f=1.46 D:\Dragon Board V1.0\LBT2\TrackerD v1.2.sch (Sheet: 3/3)
