dragino/TrackerD/hardware/TrackerD v1.2.layout.pdf

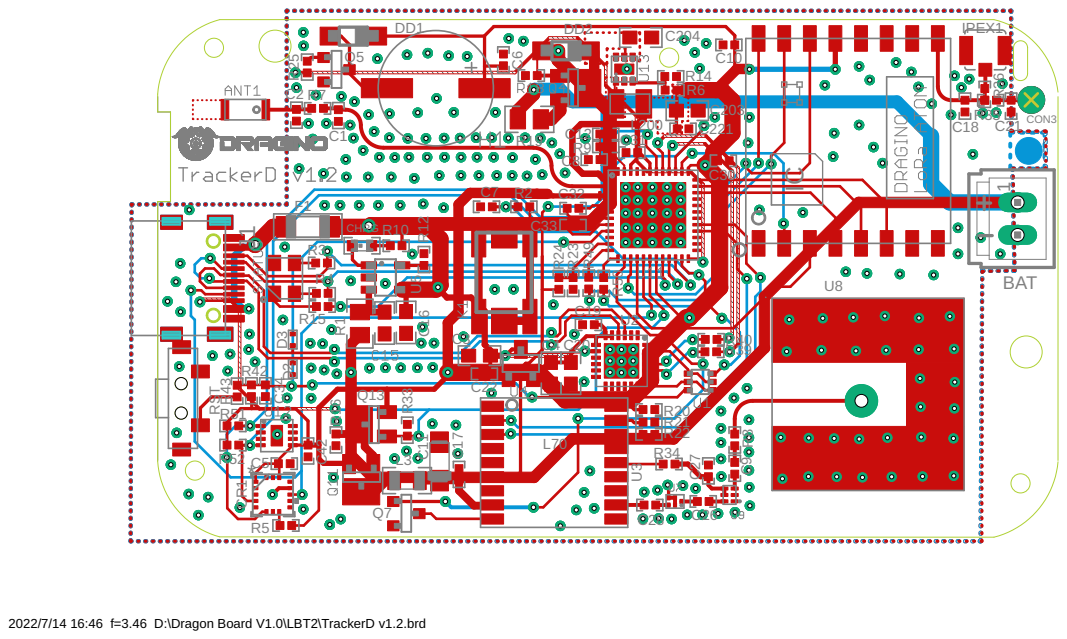
[picture p5: page 1]
