dragino/TrackerD/hardware/TrackerD v1.2.silkscreen.pdf

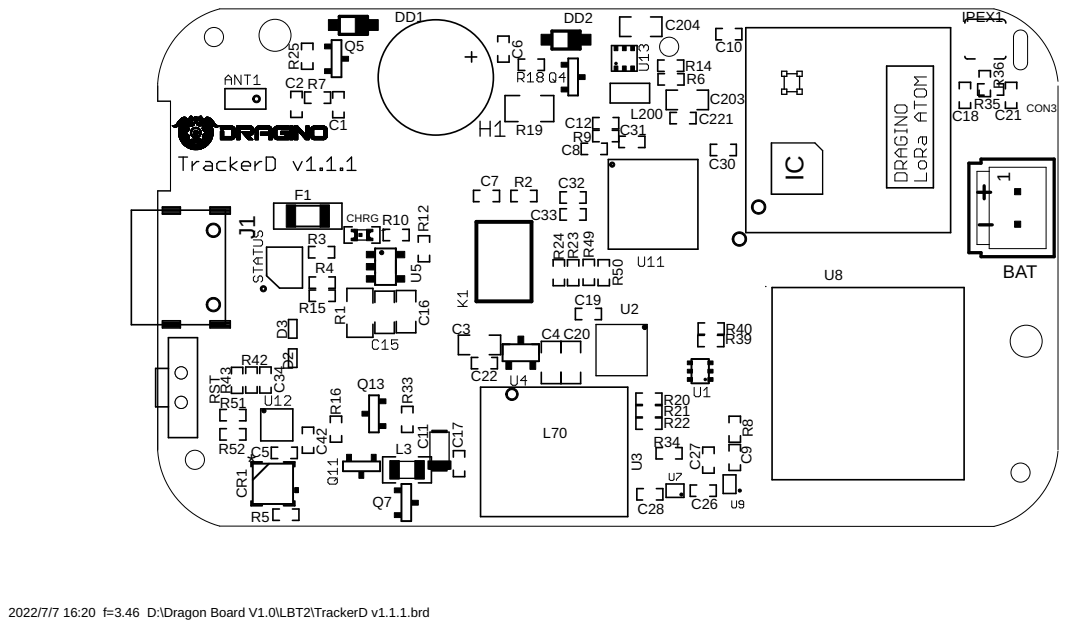
[picture p6: page 1]
