dragino/TrackerD/Example/LoRaWAN/examples/TrackerD/config.h

#ifndef _config_h_
#define _config_h_

#define Pro_model           "TrackerD "
#define Pro_version         "v1.4.9"
//#define EEPROM_SIZE         128
//#define EEPROM_KEY_SIZE     32

#define maxRxSize       128 

#define EXTI_PIN        0
#define BAT_PIN_READ    35
#define BAT_PIN_LOW     4
#define LED_PIN_RED     15
#define LED_PIN_BLUE    2
#define LED_PIN_GREEN   13
