dragino/TrackerD/(commit log)

2022-01-12 Add component list / datasheets, and first try at populating SOC pin mapping
    The known components are added, with a link to a datasheeet.
    The first try of a ESP32 SOC pin mapping is addded.
2022-01-23 Fix missing CR in some debugs
    [GXHT30.cpp, OTAA_FULL_FUNCTION.ino]
2022-01-23 Configure SPI early in the boot
    When using the standard, unmodified Arduino libraries for ESP32, the SPI library
    uses a default set of pins for SPI that are not the same that this board uses.
    We thus configure SPI as soon as possible - the library will then "remember" these
    settings later on (especially in LMIC - LoRaWan where it is used)
2022-01-25 Update parsing of serial data (AT commands from user)
    Current parsing was expecting full strings to appear in the serial buffer
    at once ; while when connected to an USB-Serial adapter the entry
    is more character per character.
    This patch tries to fill the buffer was as many as characters as possible,
    and process the line once a CR (\n) has been received - while trying to
    handle buffer overflows.
2022-10-11 v1.4.0
    Based on v1.3.0, the mode switching is simple, and the part interrupted by pressing the key is modified. The operation instructions have been updated in wiki. Increase or decrease the payload format of each uplink
2022-11-11 v1.4.2
    Fix the previous version of V1.4.2, please upgrade V1.4.2 version when you encounter similar problems.
    [GPS.cpp, TrackerD.ino, at.cpp, blescan.cpp, common.cpp, common.h, extiButton.cpp, wifiscan.cpp]
2022-11-16 Fix platformio config and apply SPI patches for build to work
2022-11-16 Add alarm melody function for buzzer
    [common.cpp, common.h, notes.h]
2022-11-23 v1.4.3
    1. When fixing AT+FDR, AT+FTIME = 0 and AT+PDOP = 0
    2. Increase the setting of the interrupt threshold of the motion sensor, AT+PT = 14
    [GPS.cpp, TrackerD.ino, at.cpp, at.h, blescan.cpp, common.cpp, common.h, config.h]
2022-11-30 v1.4.4
    1. Payload increases the motion status
    2. Fix AT+BLEMASK and AT+Wifimask cannot be saved
    [TrackerD.ino, at.cpp, blescan.cpp, common.cpp, common.h, extiButton.cpp]
2023-02-21 v1.4.0
    1,Repair in the case of SF12, the re -transmission time is too long
2023-04-24 v1.4.5
    1. Add AT+ATST command to set the AT command window time
    2. Pressing multiple times can only be in the alarm state and enter sleep
    3. When setting the motion sensor threshold, you don’t need to open AT+INTWK=1
    4. Fix the situation that the LON setting cannot be changed
    5. Press and hold for 10 seconds and quickly press three times to enter sleep. The operation is simple and will not be troublesome.
    6. Reduced power consumption during sleep across operating conditions
    7. Automatic FDR when the version is updated
    8. Added step counting function using AT+PM setting
    9. Added fall detection using AT+FD setting
    [TrackerD.ino, at.cpp, at.h, common.cpp, common.h, extiButton.cpp]
2023-05-26 v1.4.5
    Add AT+ATST command to set the AT command window time
    Pressing multiple times can only be in the alarm state and enter sleep
    When setting the motion sensor threshold, you don’t need to open AT+INTWK=1
    Fix the situation that the LON setting cannot be changed
    Press and hold for 10 seconds and quickly press three times to enter sleep. The operation is simple and will not be troublesome.
    Reduced power consumption during sleep across operating conditions
    Automatic FDR when the version is updated
    Added step counting function using AT+PM setting
    Added fall detection using AT+FD setting
    Fixed the problem that when the motion interruption threshold is too small, the device will always be int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
    [TrackerD.ino, at.cpp, common.cpp, common.h]
2023-08-03 v1.4.6
    1,Added ABP mode, AT+NJM=0, downlink 0x20 0x00.
    2,Add downlink to restore factory settings, 0x04 0xFE.
    3,Change downlink ADR=0, DR=0 command, 0x22, 0x00, 0x00, 0xFF.
    4,Added GPS UTC time for GPS payload when AT+BG=1 is uplink,downlink 0xB8 0x01.
    5,Add AT+BEEP, turn off and turn on the buzzer separately, separate from AT+LON,downlink 0xB9 0x01.
    6,Added AT+EAT, you can set the button to long press and hold the time to enter the alarm, 2~10s,0xBA 0x02.
    7,Fix long sleep, tested for 12 hours.
    [TrackerD.ino, at.cpp, at.h, blescan.cpp, common.cpp, common.h, extiButton.cpp]
2024-06-18 v1.4.9
    This version integrates TrackerD and TrackerD-LS and uses AT+DEVICE to distinguish them.
    AT+DEVICE=13-->TrackerD
    AT+DEVICE=22->TrackerD-LS
    TrackerD For versions before v1.4.9, you need to use AT+DADDR=01880788for configuration.
2024-07-19 Disable logging and sending logged GPS results if the device is in TTN Mapper mode. If GPS results are logged without TTN coverage, then transmitted when the device comes into coverage, it would resu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
2025-02-17 v1.5.3
    1，Change the sleep state, you can sleep for a long time, such as 4 hours, 24 hours, etc.
    2，When the battery voltage is lower than 2.8v, Tracker-LS prevents over-discharge and the device automatically enters deep sleep, checks the voltage every five hours, and switches to normal mode when it is higher than 3.5v.
    [GPS.cpp, TrackerD.ino, at.cpp, at.h, blescan.cpp, common.cpp, common.h, extiButton.cpp]
